vkri801/Particle-Detector/IMG_3074-20-12-17-12-42.JPG

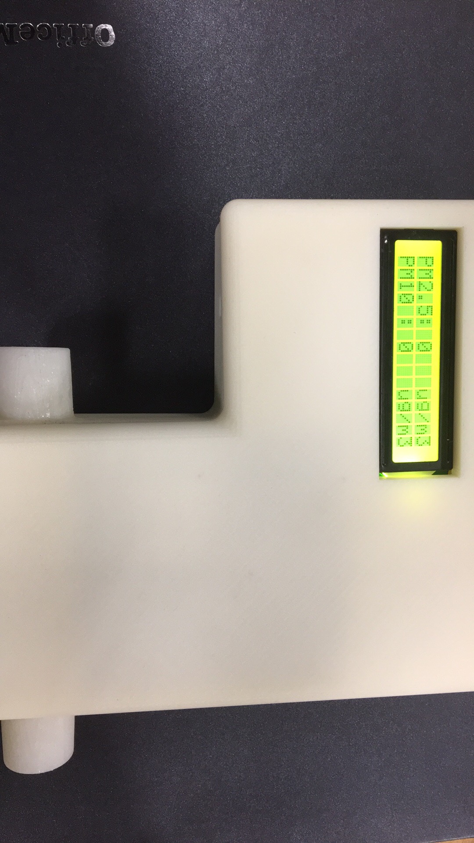
IMG_3074-20-12-17-12-42.JPG
