vkri801/Particle-Detector/IMG_3073-20-12-17-12-42.JPG

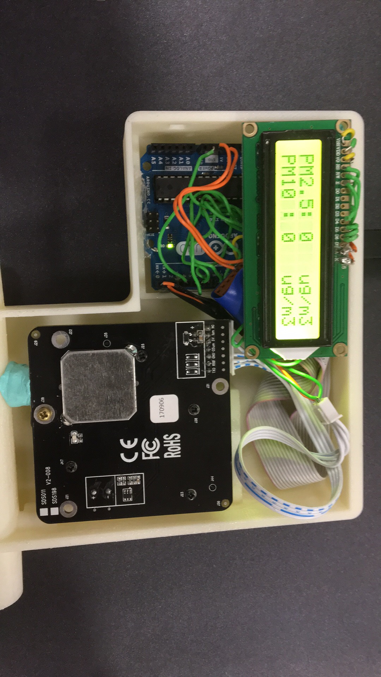
IMG_3073-20-12-17-12-42.JPG
