vkri801/Particle-Detector/README.md

# Particle-Detector
A particle detector created to work in tandem with another project. It uses a module that relies on laser scattering principle to calculate concentrations of particulate matter.
