vkri801/Particle-Detector/Particle Detector Project Summary.pdf

### Particle Detector (Personal)

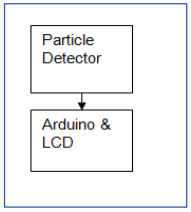
[picture p3: figure]

### 1. Objective

The particle detection module consisted of an SDS011 dust matter detector which calculated concentrations of PM2.5 and PM10. The calculated concentrations were sent to an Arduino Uno where the signal was processed, and values displayed on an LCD. The architecture of this unit is shown within Figure 1. The main purpose of this unit was to detect the presence of dust or water droplets.

### 2. Components

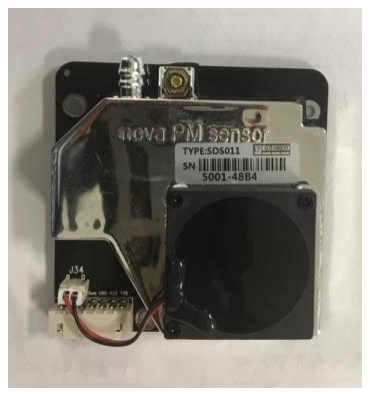
[picture p4: figure]

### 2.1 SDS011 Sensor

The SDS011 sensor from figure 2 worked on the principle of laser scattering with a digital output and measured concentrations of particles with mean diameters from 0.3 to 10 µm. Its range was 0-999 µg/m³ and it had a resolution of 0.3 µg/m³
. It utilised a
UART method of communication and was easy to integrate with an Arduino. The relative error of the sensor was a maximum of ±15% or ±10ug/m3. The serial data output frequency was fixed at 1Hz.

### 2.2 LCD-016M002B

This device was chosen to display concentration values of the particles detected. This display consisted of 2 lines with 16 characters within each. Each character was made of a 5x8 dot matrix. The DDRAM address for each display position ranged from 00 to 4F consecutively. The built-in driver and controller “KS0066” enabled compatibility with Arduino microcontrollers and the native library “LiquidCrystal.h”. The pin configuration table may be found within appendix C and a wiring diagram in subsequent sections. The rated voltage for the backlight and supply was 5V.

### 2.3 Arduino Uno Rev 3

The Uno Rev 3 board was used as a control unit for the detection module. The microcontroller available was an ATMega328P with a 16MHz clock cycle. The method used to supply power to the board was a USB cable from a PC. This also served to flash on programs using the pre-existing
bootloader and USB to serial conversion. The main functionalities utilised were timer interrupts, software serial libraries, and digital IO pins.

Figure 1: Minimalistic
detector architecture

Figure 2: SDS011 sensor

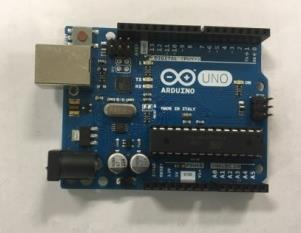
[picture p5: figure]

Figure 3: Arduino Uno

### 3. Wiring Schematic

The wiring of this module followed the specification sheets provided and the schematic is as shown

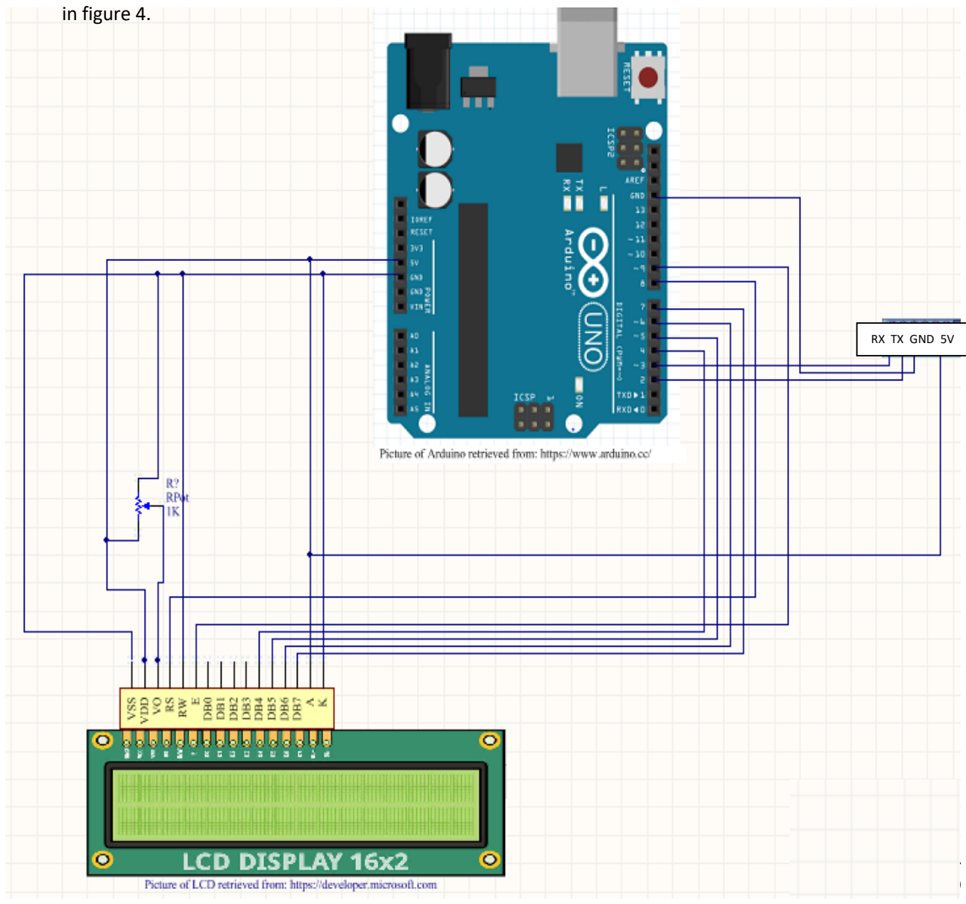
[picture p6: figure]
in figure 4.; RX TX GND 5V

Both the LCD and SDS011 sensor required a connection to the 5V pin for power supply with the LCD having three separate terminals requiring a connection to it. A miniature proto board was utilised for the 5V pin and the separate ground connections together with the placement of the trim potentiometer for contrast adjustment. Digital IO pins 4-9 were used for the LCD with 8 and 9 being the write and enable pins respectively. Pins 2 and 3 were used for RX and TX corresponding to the TX and RX terminals on the SDS011. This was utilised together with the software serial library. The reason for this was pin 1, the original RX pin, was utilised by the bootloader for flashing on programs.

Figure 4: Wiring schematic of LCD, SDS011, and Arduino made on Altium

### 4. Software Design

Arduino IDE which is based on AVR C++/C was the environment in which all programs were coded. The two native libraries which were extensively utilised were: “LiquidCrystal.h” and “SoftwareSerial.h”.

### 4.1 LCD Functionality

The previously mentioned library was object oriented and so an instance was made with pins 4, 5, 6, 7, 8 and 9. The display for both is as shown in figure 5 with PM2.5 values on the first line and PM10 values on the second.

### 4.2 SDS011 Functionality

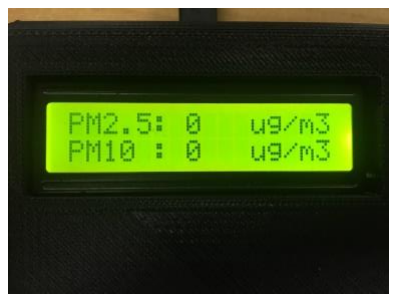
[picture p7: figure]

The “SoftwareSerial.h” library allowed pins 2 and 3 to mimic the functionality of RX and TX pins. The serial read functionality was implemented within an interrupt vector. The overflow interrupt occurred every 0.9 seconds and was made using a prescalar of 256 and a 16-bit timer. A period close to 0.9 seconds was chosen as the hardware refresh rate was a second. The preloading of the timer used the relationship found in equation 1 where “T” is the period and “Preload” is the number of ticks till the interrupt subtracted from the number of ticks in the timer.

Preload = 2

16 −

16MHz
256
T | (1)

An array of 10 elements held each packet of 10 bytes with checks done for data stability. There was no parity bit available within the packet. The check-sum byte was constantly evaluated with equation 2.

Cℎecksum = ∑ DataN ⁶
N=1

(2)

The values for PM2.5 and PM10 concentrations were calculated using their high and low bytes. Information on each byte and their description is found within appendix B. The concentrations were calculated and displayed from equations 3 and 4 with units of µg/m³

PM2.5 Value =

(PM2.5 ℎigℎ byte)( 2

8
)+PM2.5 low byte
10

(3)

PM10 Value =

(PM10 ℎigℎ byte)( 2

8
)+PM10 low byte
10

(4)

Figure 5: Displaying PM10 and PM2.5 values

### 4.3 FIR filter (Moving average)

Due to ripples present at steady state, the displayed value would fluctuate leading to unstable measurements. To alleviate this problem, a simple moving average filter was designed and implemented with the graph showing comparisons of filtered and unfiltered data shown in Figure 6. The number of data points for an average was originally 15 which smoothed out sharp transitions, but ripples were still present as shown in the figure. A filter with 30 data points or more is advised but within reason. More data points collected means a higher response settling time. The MATLAB graphing program is within appendix D.

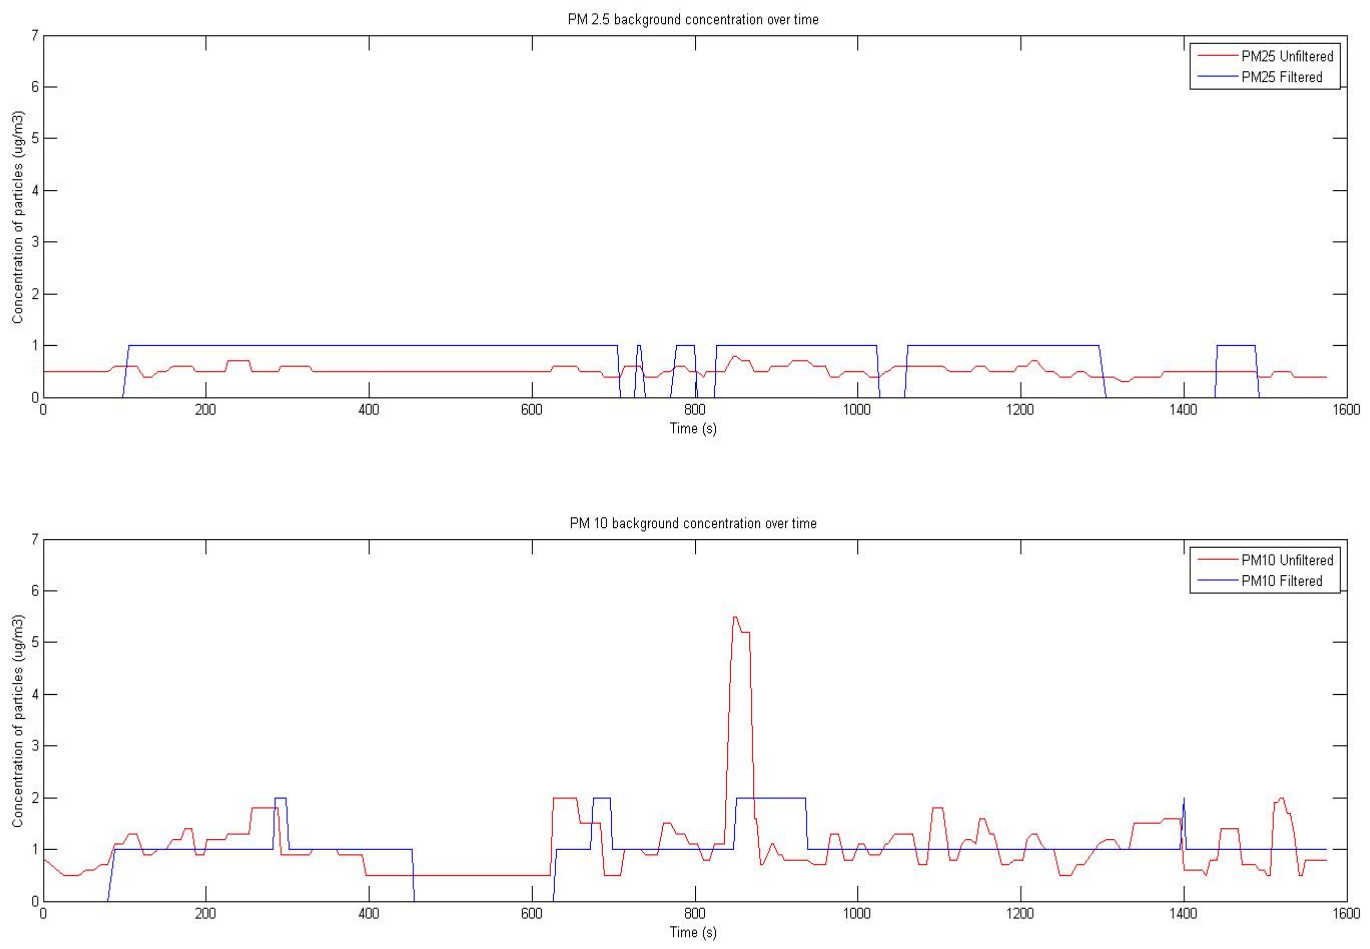
[picture p8: figure]

Figure 6: Two graphs of PM2.5 and PM 10 data of both filtered and unfiltered results

### 5. Enclosure Design

The enclosure was designed around the three main components with special care taken for the dimensions of the SDS011 sensor. The top cover and bottom shell both had numerous dimensions to account. Both the cover and bottom shell were printed with ABS material on an FDM printer. An assembly for both components together with models depicting an LCD and the arduino are shown in Figures 7 and 8.

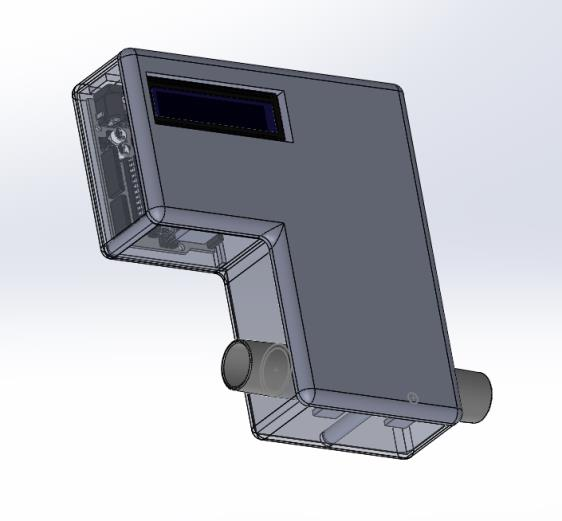
[picture p9: figure]
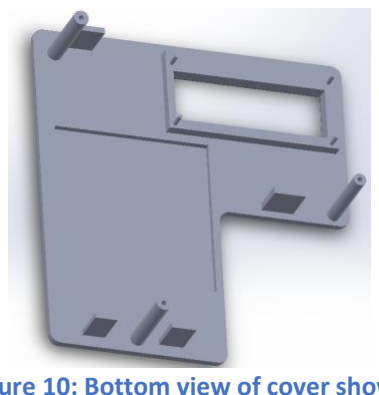
[picture p10: figure]

### 5.1 Top Cover

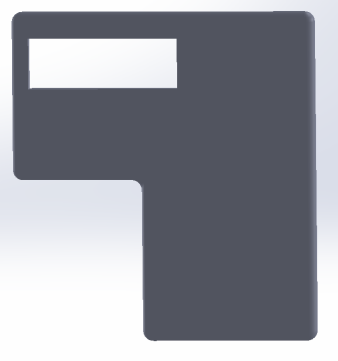
[picture p11: figure]

Figure 9: Front top view of cover

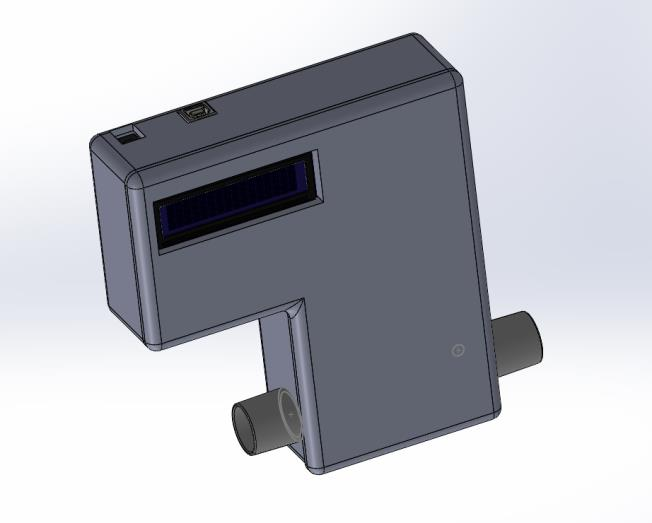
[picture p12: figure]

The top cover has a slot for the LCD measured at 72.5mm x 24.5mm with four extrusions that enable a fit as seen in Figures 9 and 10. Three long extrusions are present for screws to hold the top enclosure to the bottom.

Figure 10: Bottom view of cover showing extrusions.

Figure 7: Assembly view to show flow pathway, LCD, and arduino

Figure 8: Assembly view showing USB and DC ports

### 5.2 Bottom shell

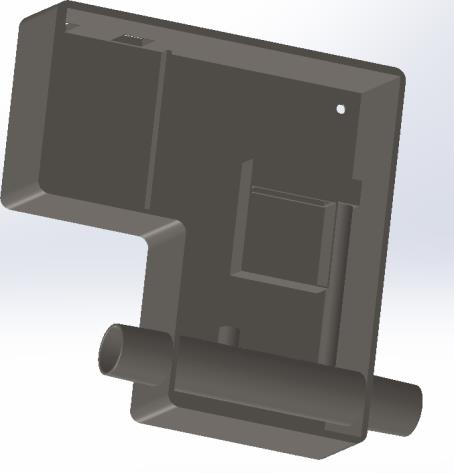
[picture p13: figure]

Figure 11: Bottom shell model

The bottom shell consisted of three major sections. The first is the area where the arduino would be placed, the second a slot for the SDS011 sensor and its fan, and third a flow pathway for entrance and exit of airflow containing moisture. The functional diameters for the flow pathway were both 22.5mm tapering off to 21.5mm for fittings. The hose outlet as shown in Figure 11 had an inner diameter of 6mm and an external diameter of 8mm for attachment to the sensor. The opening for the USB port which was primarily utilised was measured to be 11.7mm x 13mm.

The overall dimensions of the envelope for the entire module were measured to be 160mm x 148mm x 48mm.

### 6. Results

The module enclosure designed was firm and housed the components while providing a flow sample to the sensor. Figure 12 shows the enclosure with the components powered up. The screws held together the casing well. The port for the USB is functional and holds the cable in place.

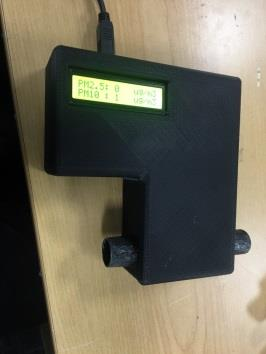
[picture p14: figure]

As seen from figure 13, the graph shows detection of water droplets when atomised water was introduced was 1350 seconds from start. The gradient is lower for the filtered plot compare to the unfiltered plot and response time is clearly slower as was mentioned.

Figure 12: Particle
detection module

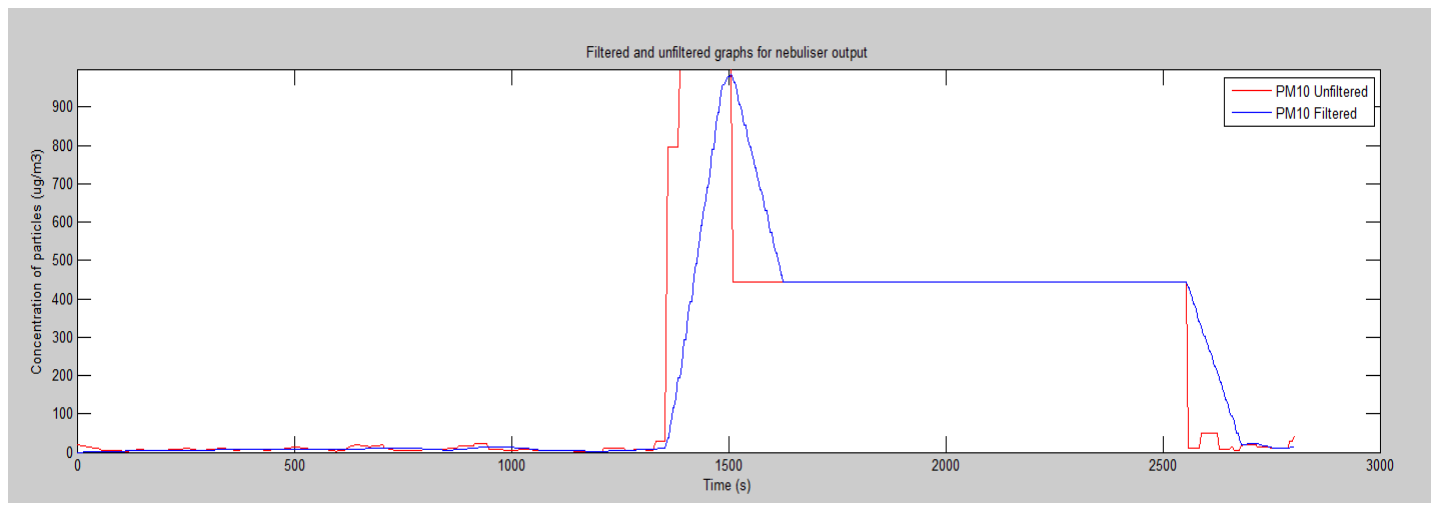
[picture p15: figure]

Figure 13: Graph of particle detection module while nebuliser was on

### Appendix A: Software for detection module

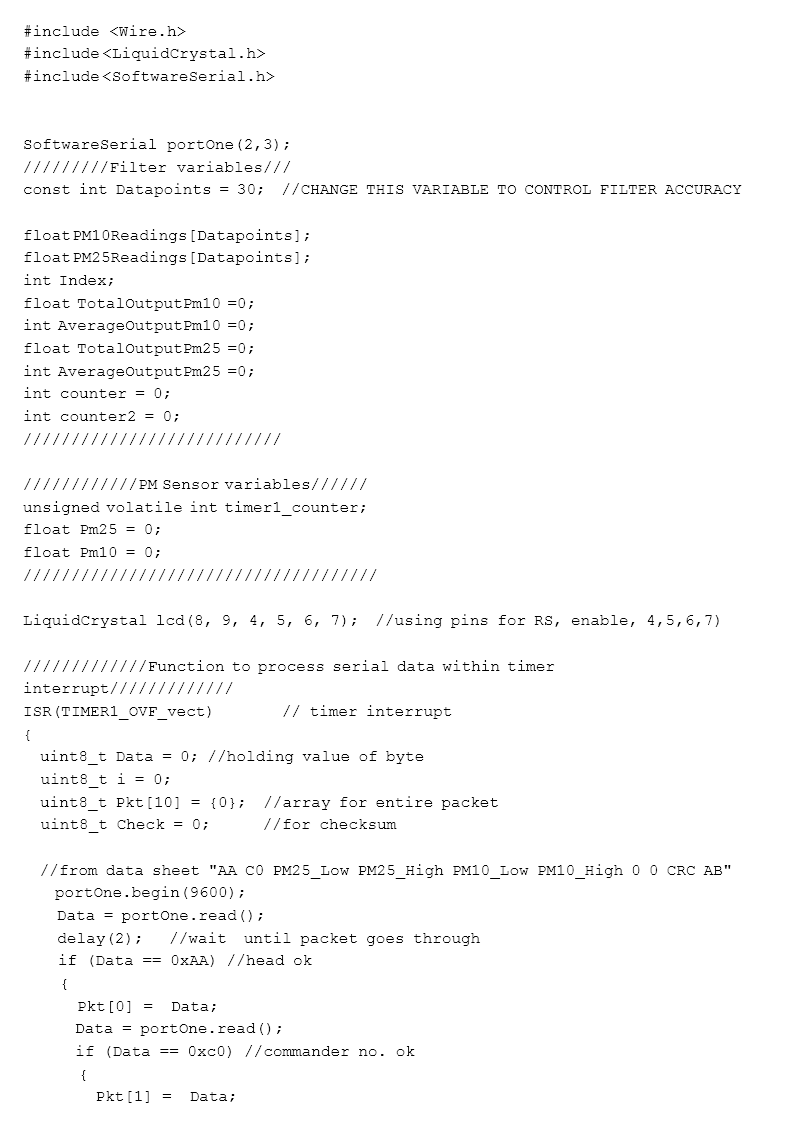
[picture p16: figure]

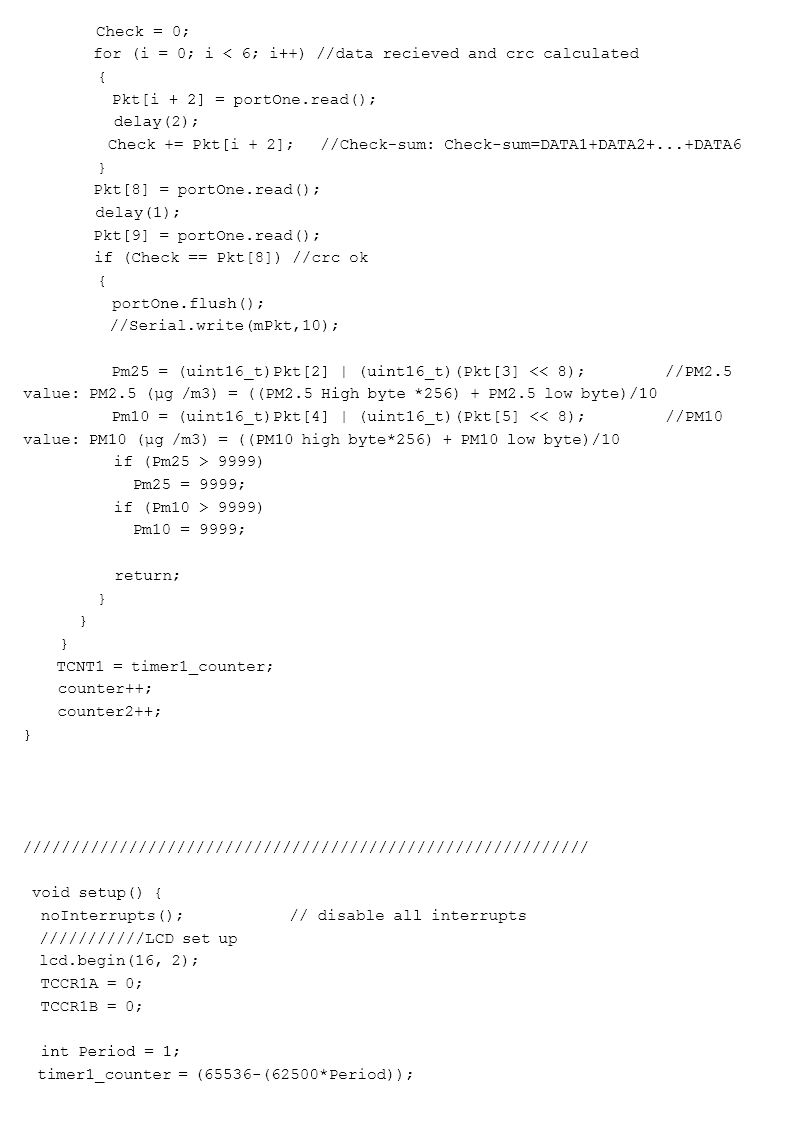
[picture p17: figure]

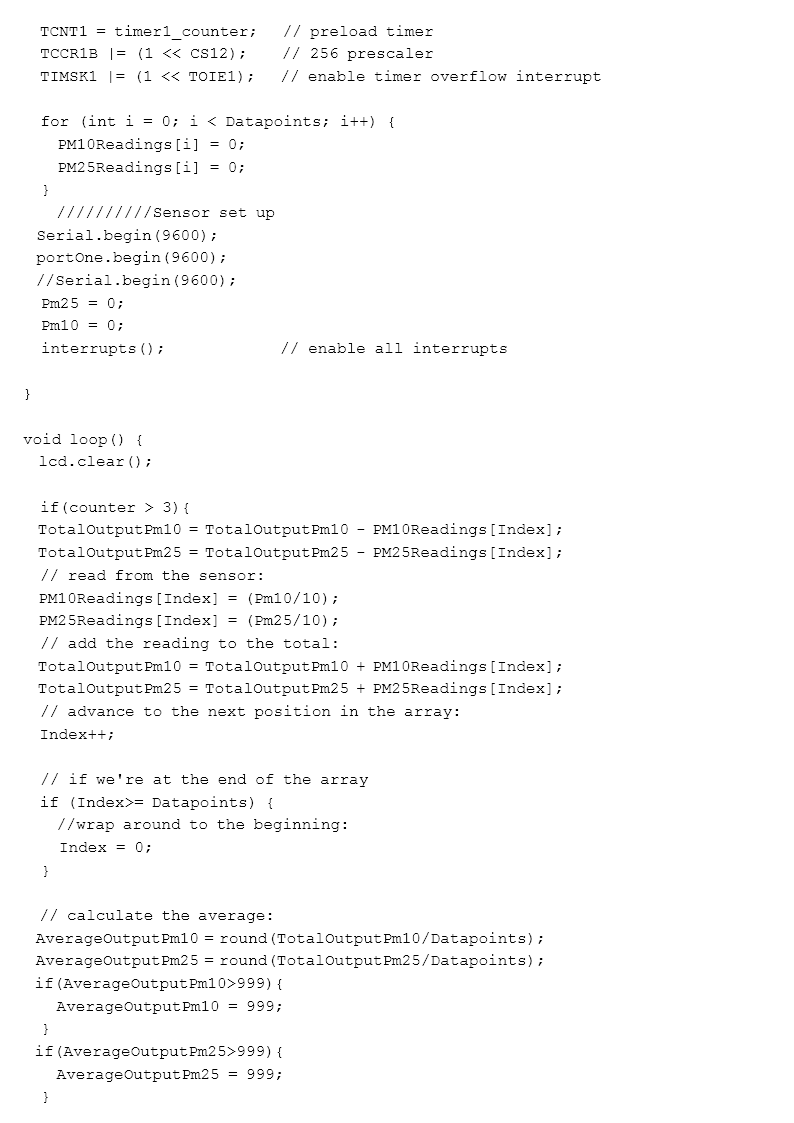
[picture p18: figure]

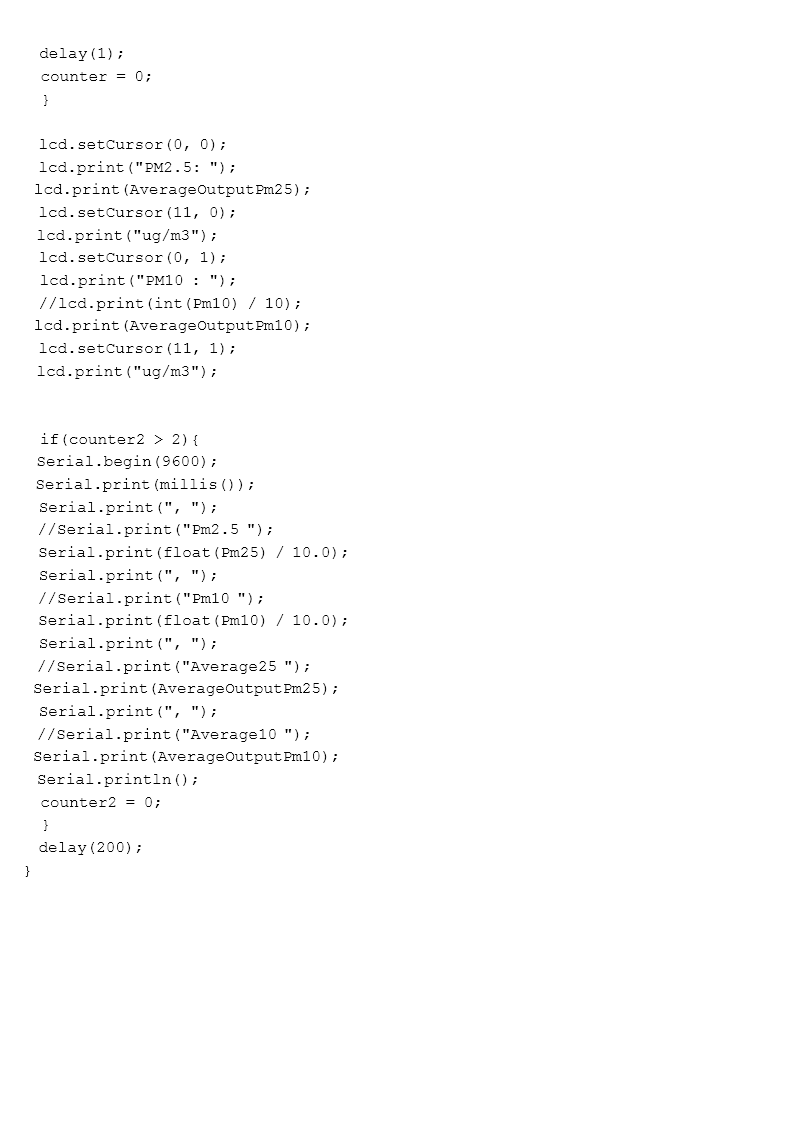
[picture p19: figure]

### Appendix B: SDS011 sensor specifications and basic dimensions

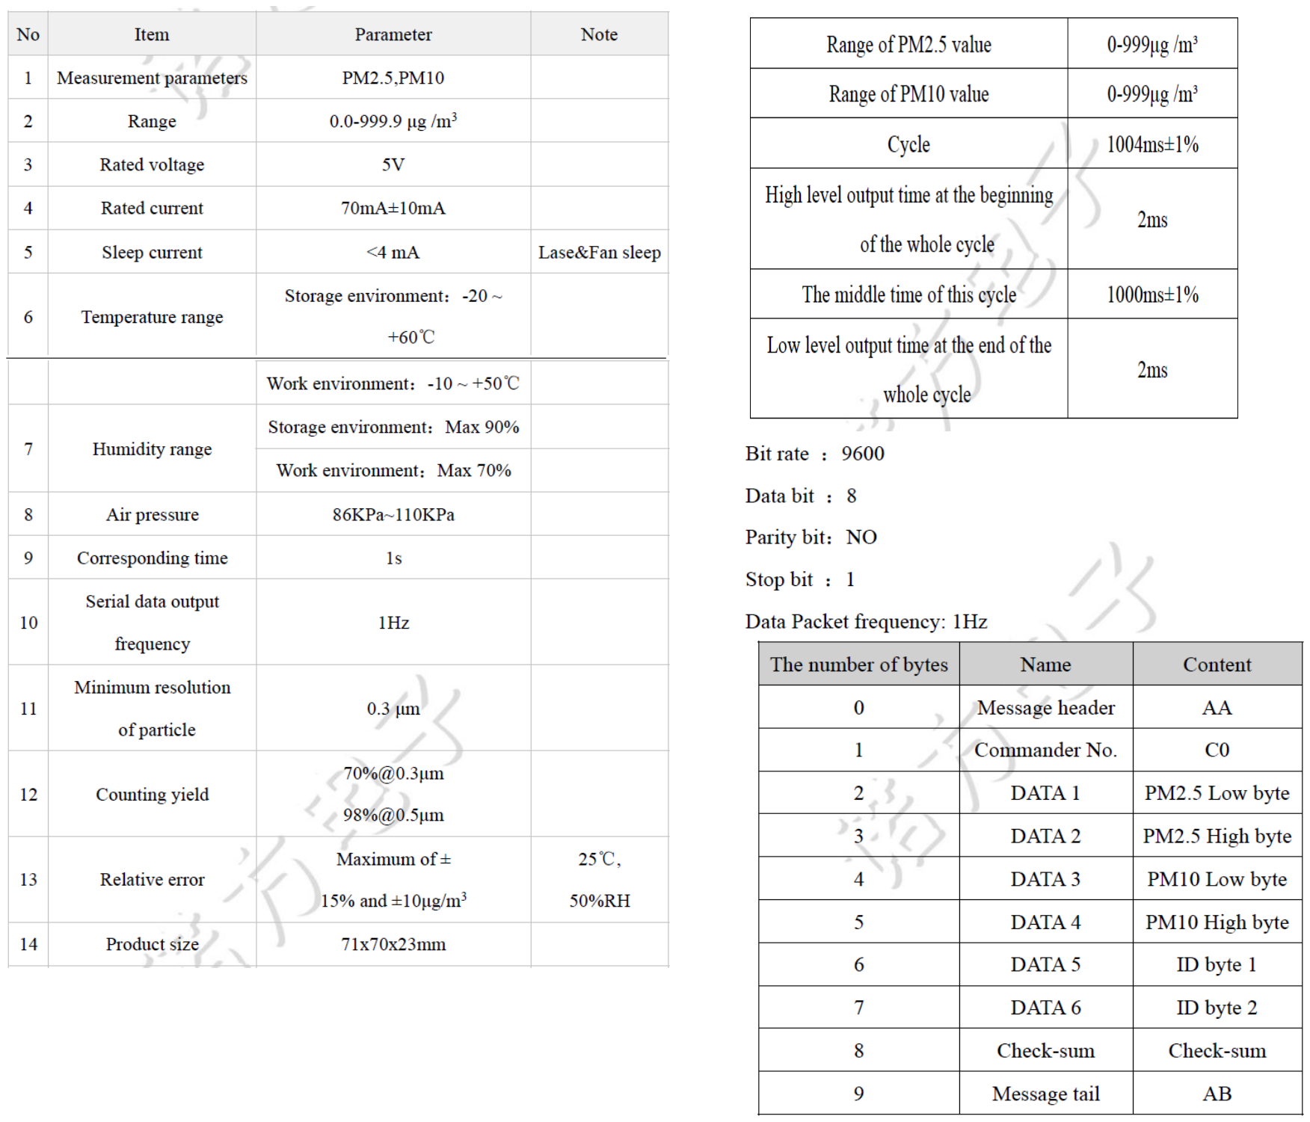
[picture p20: figure]
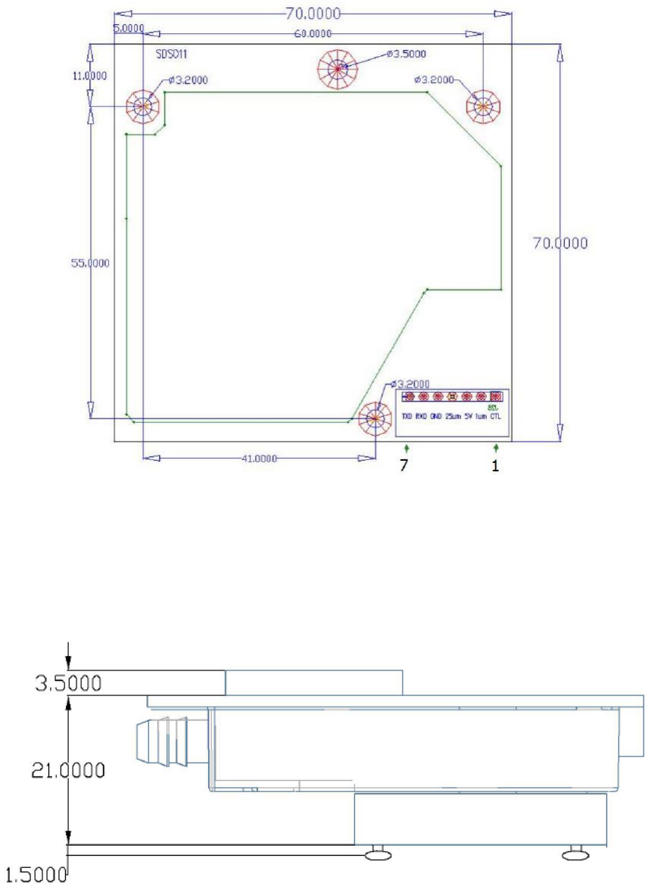
[picture p21: page 13]
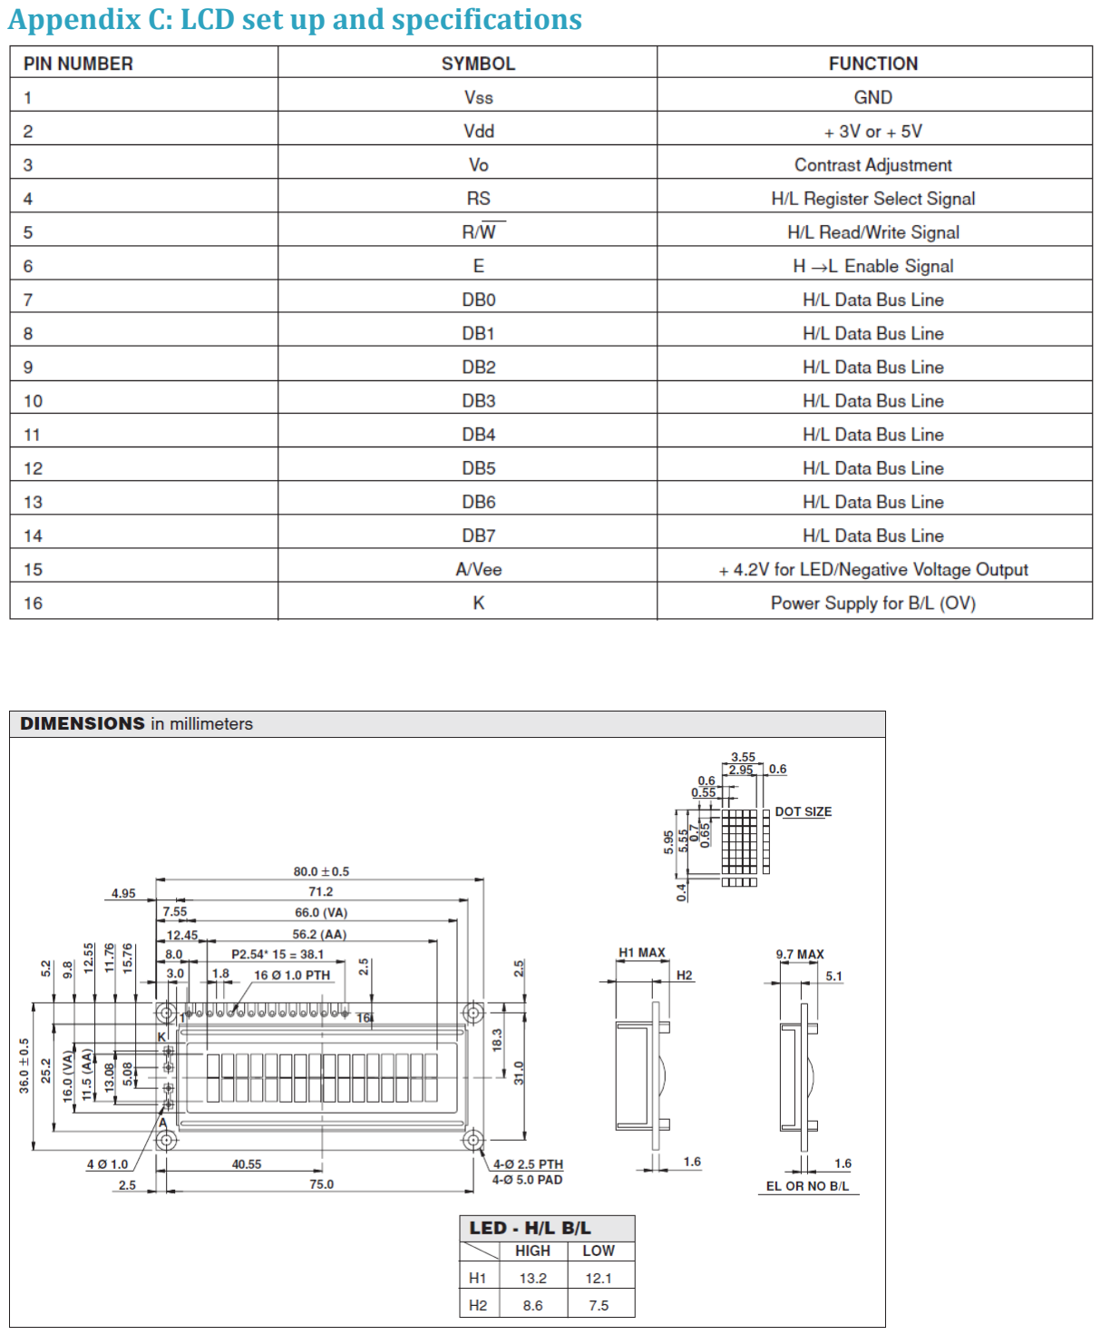
[picture p22: page 14]

### Appendix C: LCD set up and specifications

### Appendix D: MATLAB code for plotting sensor data

%%Before running, please import data from excel sheet

Time = (Timemsfromstart - Timemsfromstart(1))/1000; % start time from 0 seconds

%%
figure
subplot(2,1,1)
%subplot of PM25 filtered and unfiltered data plot(Time,PM25Unfiltered,'r',Time,PM25filtered,'b');
ylim([0 999]); %%Change second value to control size of y axis xlabel('Time (s)');
ylabel('Concentration of particles (ug/m3)');
legend('PM25 Unfiltered', 'PM25 Filtered')

subplot(2,1,2)
%subplot of PM10 filtered and unfiltered data plot(Time,PM10Unfiltered,'r',Time,PM10filtered,'b');
ylim([0 999]); %%Change second value to control size of y axis xlabel('Time (s)');
ylabel('Concentration of particles (ug/m3)');
legend('PM10 Unfiltered', 'PM10 Filtered')
%%
