vkri801/Particle-Detector/IMG_3044-15-12-17-07-14.JPG

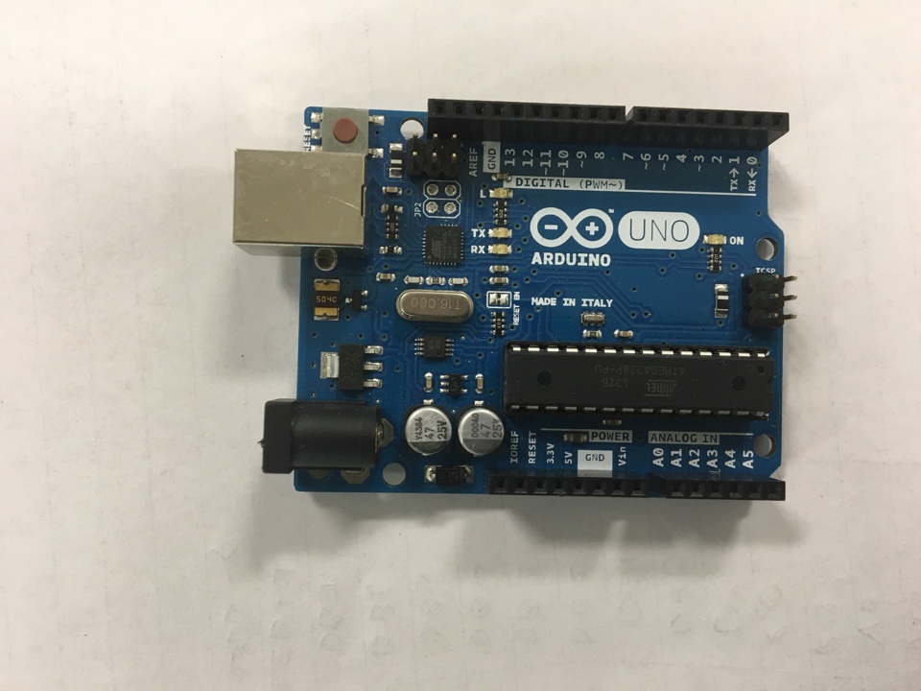
IMG_3044-15-12-17-07-14.JPG
