vkri801/Particle-Detector/IMG_3085-20-12-17-12-42.JPG

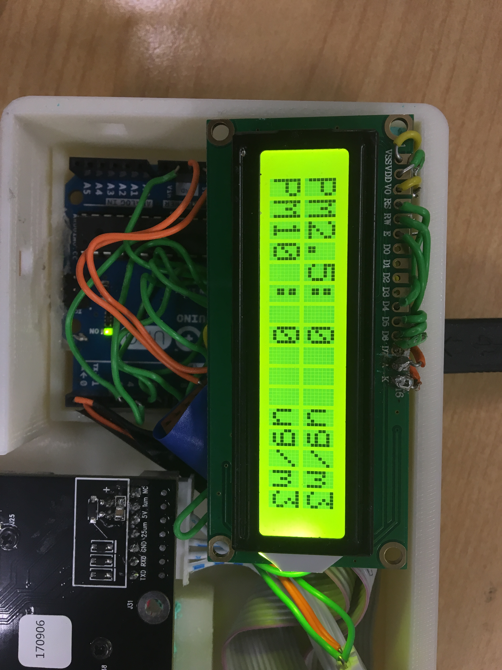
IMG_3085-20-12-17-12-42.JPG
