vkri801/Particle-Detector/IMG_3193-12-01-18-08-21.JPG

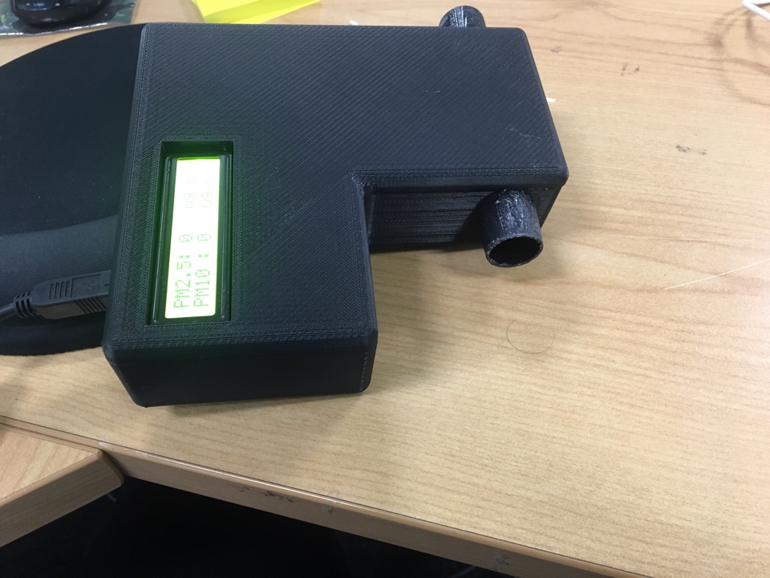
IMG_3193-12-01-18-08-21.JPG
