vkri801/Particle-Detector/Enclosure_Assemble/DFRobot_1602_LCD.SLDASM

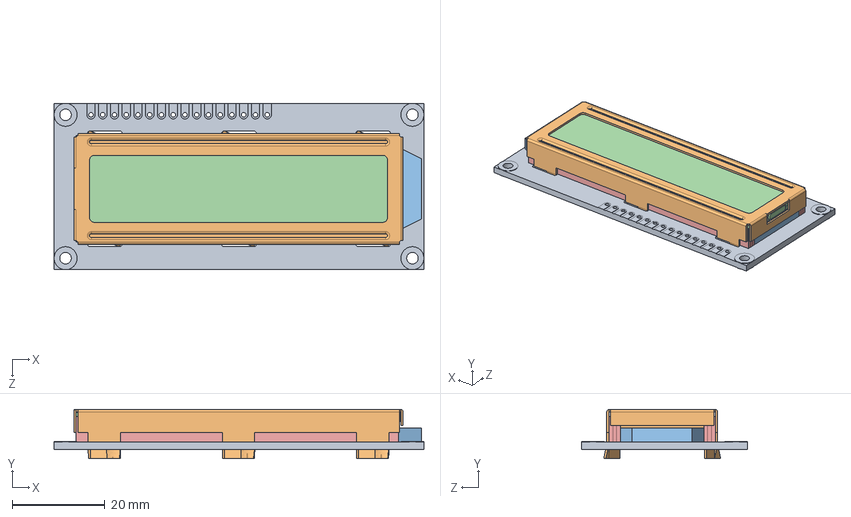
[picture p27: CAD file, 2019-10-08]
Enclosure_Assemble/DFRobot_1602_LCD.SLDASM
80.0 x 10.6 x 36.0 mm
LCD_PCB
metal_casing
LCDbacklight
LCD
conductors x 2
