vkri801/Particle-Detector/Enclosure_Assemble/Male 22mm conical_original.SLDPRT

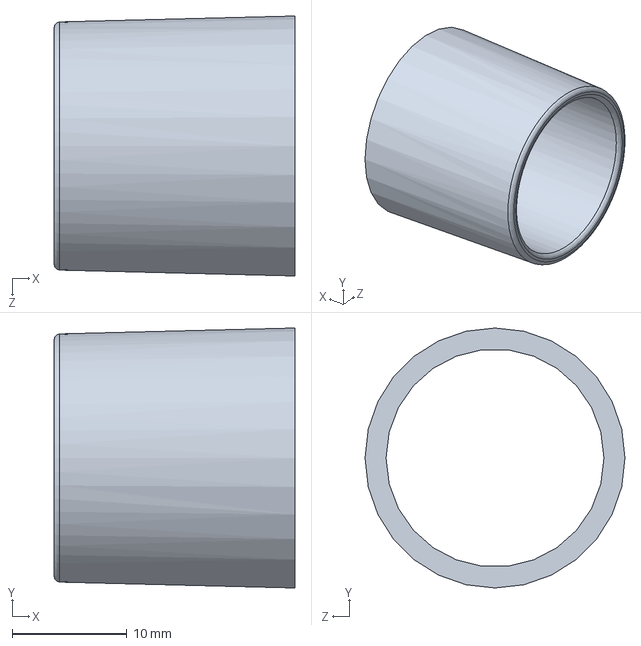
[picture p28: CAD file, 2019-10-08]
Enclosure_Assemble/Male 22mm conical_original.SLDPRT
21.0 x 22.7 x 22.7 mm
