vkri801/Particle-Detector/Enclosure_Assemble/Enclosure_Top.SLDPRT

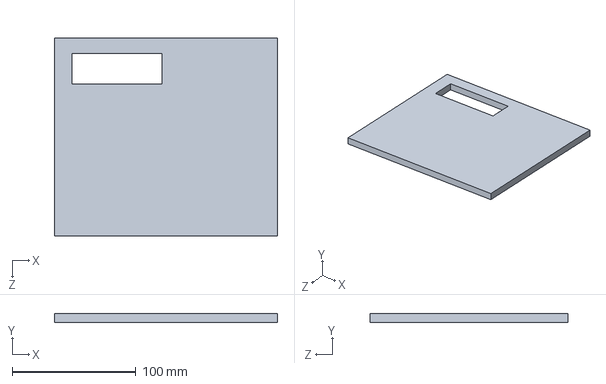
[picture p29: CAD file, 2019-10-08]
Enclosure_Assemble/Enclosure_Top.SLDPRT
180.0 x 7.00 x 160.0 mm
