vkri801/Particle-Detector/Enclosure_Assemble/conductors.SLDPRT

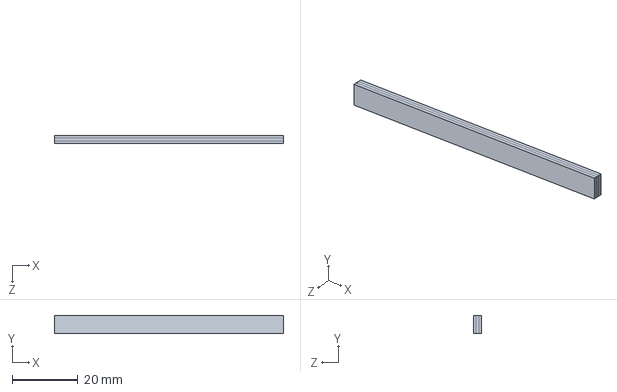
[picture p30: CAD file, 2019-10-08]
Enclosure_Assemble/conductors.SLDPRT
69.7 x 5.50 x 2.50 mm
