vkri801/Particle-Detector/Enclosure_Assemble/LCDbacklight.SLDPRT

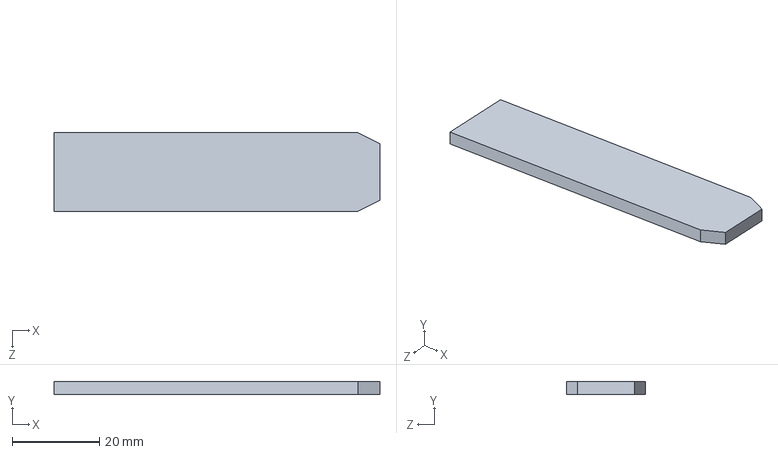
[picture p31: CAD file, 2019-10-08]
Enclosure_Assemble/LCDbacklight.SLDPRT
74.7 x 3.00 x 18.0 mm
