vkri801/Particle-Detector/Enclosure_Assemble/Sensor_Block.SLDPRT

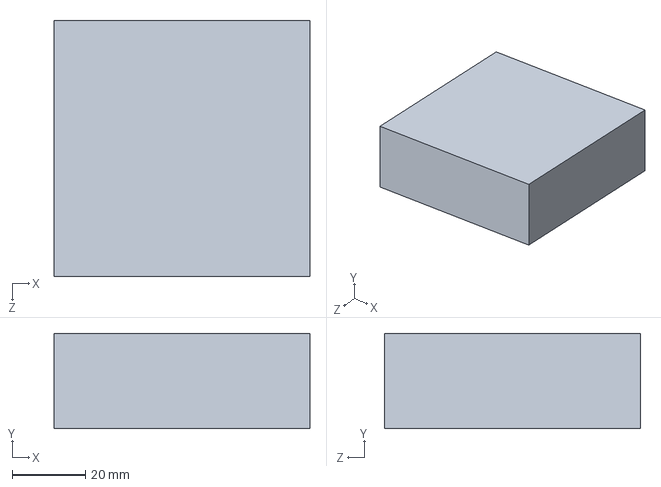
[picture p32: CAD file, 2019-10-08]
Enclosure_Assemble/Sensor_Block.SLDPRT
70.0 x 26.0 x 70.0 mm
