vkri801/Particle-Detector/Enclosure_Assemble/metal_casing.SLDPRT

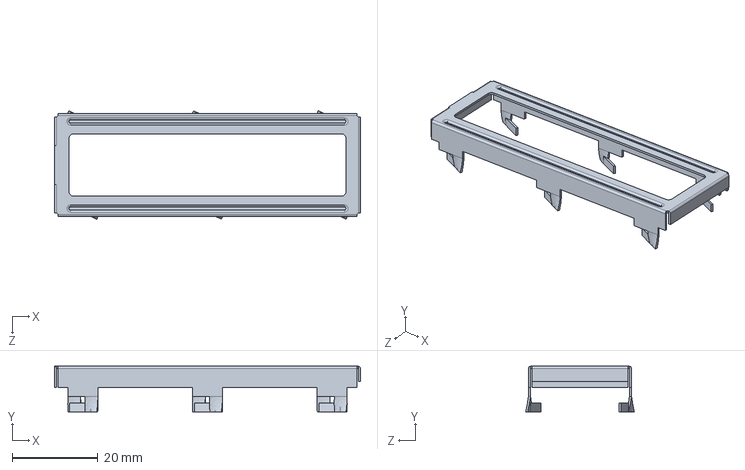
[picture p33: CAD file, 2019-10-08]
Enclosure_Assemble/metal_casing.SLDPRT
71.2 x 10.6 x 25.3 mm
