vkri801/Particle-Detector/Enclosure_Assemble/LCD_PCB.SLDPRT

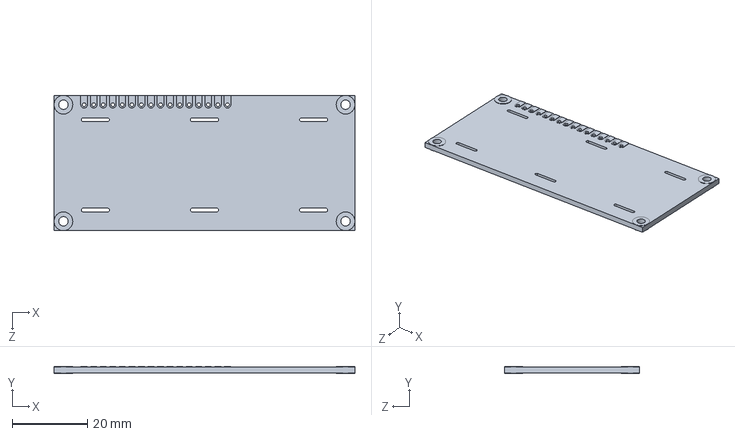
[picture p34: CAD file, 2019-10-08]
Enclosure_Assemble/LCD_PCB.SLDPRT
80.0 x 1.80 x 36.0 mm
