vkri801/Particle-Detector/Enclosure_Assemble/Enclosure_Bottom.SLDPRT

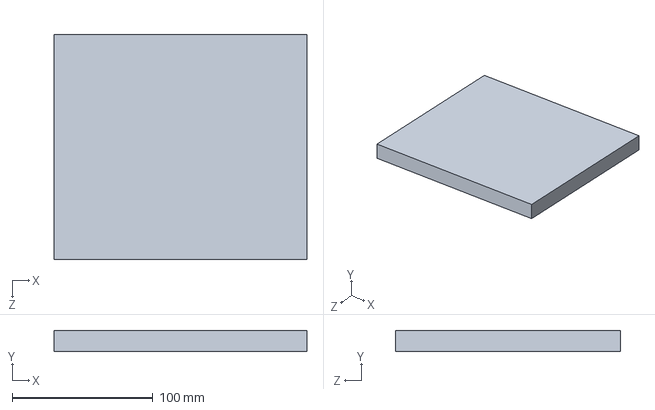
[picture p35: CAD file, 2019-10-08]
Enclosure_Assemble/Enclosure_Bottom.SLDPRT
180.0 x 15.0 x 160.0 mm
