vkri801/Particle-Detector/Enclosure_Assemble/Male 22mm conical_a.sldprt

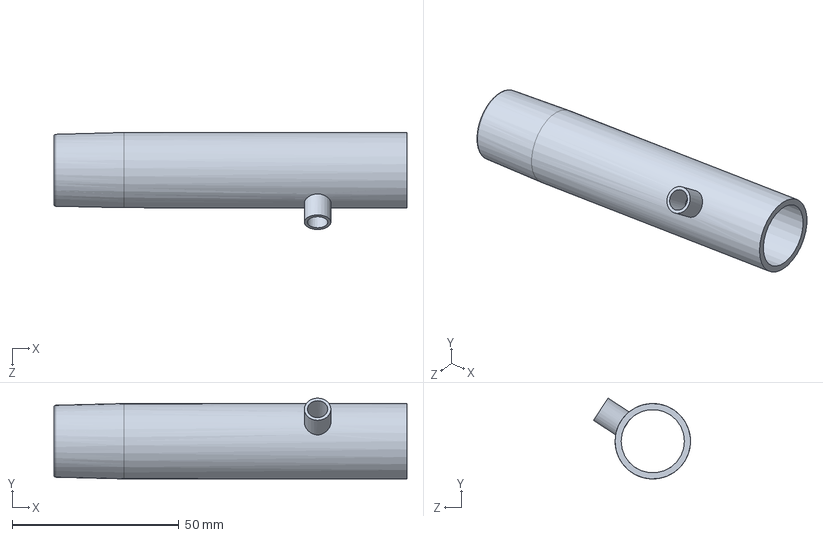
[picture p36: CAD file, 2019-10-08]
Enclosure_Assemble/Male 22mm conical_a.sldprt
106.0 x 24.3 x 29.2 mm
