vkri801/Particle-Detector/Enclosure_Assemble/Enclosure Assembly2.JPG

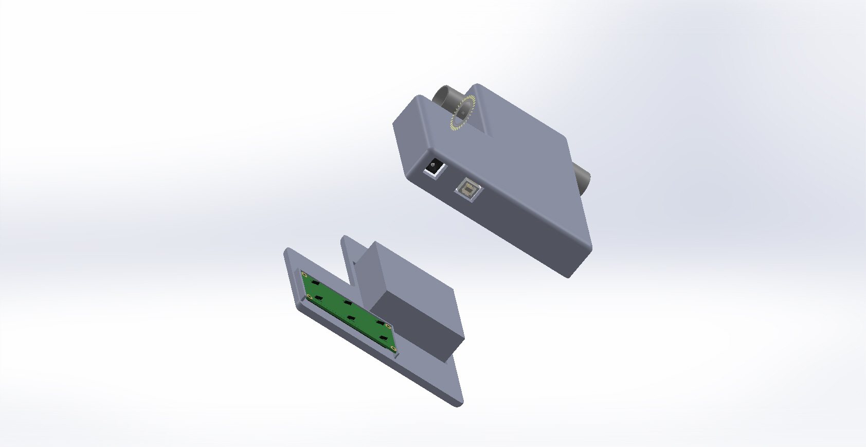
Enclosure_Assemble/Enclosure Assembly2.JPG
