vkri801/Particle-Detector/Enclosure_Assemble/Enclosure Assembly3.JPG

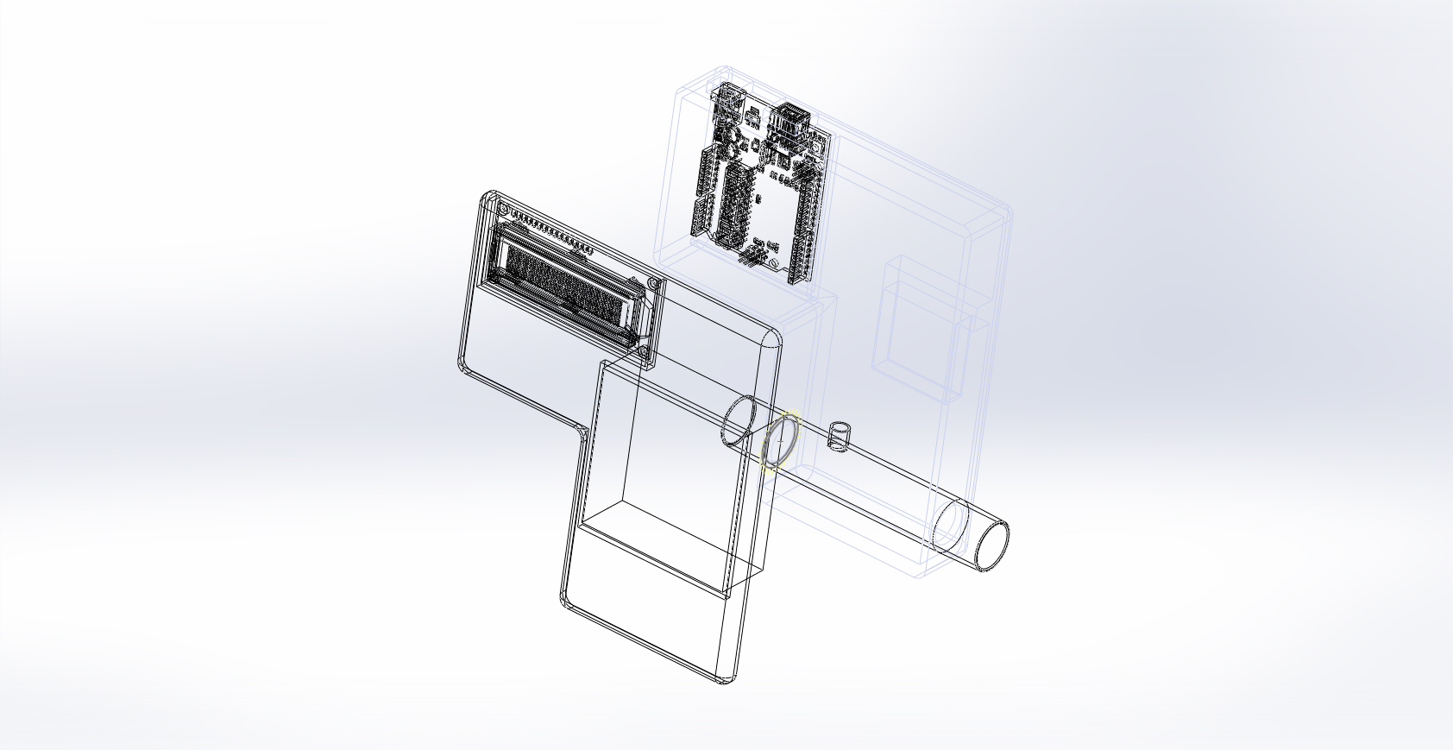
Enclosure_Assemble/Enclosure Assembly3.JPG
