vkri801/Particle-Detector/Enclosure_Assemble/Enclosure Assembly.JPG

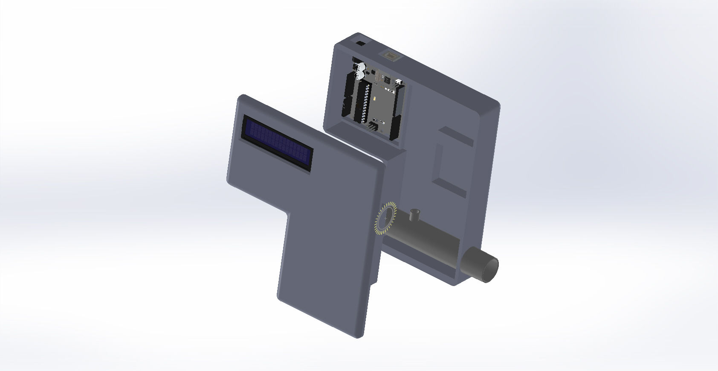
Enclosure_Assemble/Enclosure Assembly.JPG
